eric-haney/tach-fixer/(commit log)

2024-11-10 Save calibration factor to preferences.
2024-11-10 Add schematic.
2024-11-24 Update schematic.
2024-11-24 Fix signal clipping diode direction in schematic.
